veljkoidjuski/povezivanjeRobotskeiLjudskeSake/README.md

Ћао свима! Ми смо група будућих електротехничара рачунара из Средње техничке школе Сомбор :) Ово је веб-презентација нашег најновијег рада.

slikaRukovanje

<span class="oznaceniTekst">,,С левом до победе''</span> слоган је с краја новембра 2025, скован у сврху шале на рачун чињенице да је моделована роботска шака, која је требала бити десна, испала --- лева. Тај низ речи, међутим, постао је временом симбол нашег рада и посвећености остваривању амбициозне замисли: да се од свакодневних, приступачних материјала и школске електронске опреме, без икаквих софистицираних сензора и сличних склопова, направи <span class="oznaceniTekst">приступачан, libre систем с роботском шаком </span> који би могао прецизно пратити покрете људске шаке те тако помоћи човеку у изазовима свакодневнице, било да се ради о опасним индустријским задацима или печењу колача.

Дефинисани циљ пројекта јесмо испунили, али крај се не назире. Стремимо расту пројекта и свим срцем хрлимо у нове инжењерске подвиге! Подржите нас на нашем путу до победе: прва станица --- <span class="oznaceniTekst"> Галаксија куп! </span>

<p align=center>
<video controls style="width:80%">
  <source src="{{ '/video.mp4' | relative_url }}" type="video/mp4">
</video>
</p>

<hr/>

## Новости
