veljkoidjuski/povezivanjeRobotskeiLjudskeSake/elaborat/input.tex

\documentclass[a4paper, 12pt]{article}
\usepackage{amsmath}
\usepackage{fontspec}
\usepackage{setspace}
\usepackage{mathspec}
%\usepackage{unicode-math}
\usepackage{bm}
\setmathfont{Latin Modern Math}
%\setmathfont{XITS Math}
%\setmainfont{Nimbus Roman}
%\setmainfont{Times New Roman}
\setmainfont{XITS}

\makeatletter
\renewcommand\footnotesize{%
  \@setfontsize\footnotesize{10pt}{12pt}}
\makeatother

\usepackage{caption}
\captionsetup{font=footnotesize}
\usepackage{lipsum}
\usepackage{geometry}
\usepackage{afterpage}
\usepackage{graphicx}
\usepackage[serbianc]{babel}
\geometry{top=2cm, bottom=2.5cm, left=2.5cm, right=2.5cm}

\usepackage{setspace}
\usepackage{microtype}

\linespread{1.5}

\begin{document}
\newgeometry{top=5cm, bottom=2.5cm, left=2.5cm, right=2.5cm}

\begin{center}
\textls[250]{\textbf{\fontsize{14pt}{21pt}\selectfont{ПОВЕЗИВАЊЕ РОБОТСКЕ И ЉУДСКЕ ШАКЕ}}}

\textls[250]{\textbf{\fontsize{14pt}{21pt}\selectfont{CONNECTING ROBOTIC AND HUMAN HANDS}}}

\vskip.5\baselineskip

\phantom{.}\hfil \textbf{ВЕЉКО ИЂУШКИ} \hfil \textbf{МИЛОШ МЕЋАВА} \hfil \textbf{АЛЕКСЕЈ ГУДЕЉ} \hfil \phantom{.}

3. и 4. разред Средње техничке школе Сомбор

\vskip.75\baselineskip

\textls[250]{МЕНТОРИ}

\vskip.5\baselineskip

\textbf{МАРИЈАНА БОГДАНОВИЋ}

дипл. инж. електротехнике, СТШ Сомбор

\vskip.5\baselineskip

\textbf{ГОРАН ОПСЕНИЦА}

инж. електронике и телекомуникација, Bosch Србија

\end{center}

\vskip.75\baselineskip

\centerline{\textls[250]{\textbf{1. РЕЗИМЕ}}}
\vskip.5\baselineskip
\input{rezime.txt}

\newgeometry{top=2cm, bottom=2.5cm, left=2.5cm, right=2.5cm}
\centerline{\textls[250]{\textbf{2. ПРИНЦИП РАДА И ПРАКТИЧНА РЕАЛИЗАЦИЈА}}}
\vskip.5\baselineskip
\input{princip.txt}

\vskip.75\baselineskip
\centerline{\textls[250]{\textbf{3. РЕЗУЛТАТ}}}
\vskip.5\baselineskip
\input{rezultati.txt}

\vskip.75\baselineskip
\centerline{\textls[250]{\textbf{4. ЗАКЉУЧАК}}}
\vskip.5\baselineskip
\input{zakljucak.txt}

\vskip.75\baselineskip
\centerline{\textls[250]{\textbf{5. ЗАХВАЛНИЦА}}}
\vskip.5\baselineskip
\input{zahvalnica.txt}

\vskip.75\baselineskip
\fontsize{10pt}{0pt}\selectfont

\centerline{\textls[250]{\textbf{6. ЛИТЕРАТУРА И РЕФЕРЕНЦЕ}}}
\vskip10pt

\input{literatura.txt}

\end{document}
