veljkoidjuski/povezivanjeRobotskeiLjudskeSake/elaborat/assets/input.tex

\documentclass[a4paper, 12pt]{article}
\usepackage{amsmath}
\usepackage{fontspec}
\usepackage{setspace}
\usepackage{mathspec}
%\usepackage{unicode-math}
\usepackage{bm}
\setmathfont{Latin Modern Math}
%\setmathfont{XITS Math}
%\setmainfont{Nimbus Roman}
%\setmainfont{Times New Roman}
\setmainfont{XITS}

\makeatletter
\renewcommand\footnotesize{%
  \@setfontsize\footnotesize{10pt}{12pt}}
\makeatother

\usepackage{caption}
\captionsetup{font=footnotesize}
\usepackage{lipsum}
\usepackage{geometry}
\usepackage{afterpage}
\usepackage{graphicx}
\usepackage[serbianc]{babel}
\geometry{top=2cm, bottom=2.5cm, left=2.5cm, right=2.5cm}

\usepackage{setspace}
\usepackage{microtype}

\linespread{1.5}

\begin{document}
\newgeometry{top=5cm, bottom=2.5cm, left=2.5cm, right=2.5cm}

\begin{center}
\textls[250]{\textbf{\fontsize{14pt}{21pt}\selectfont{ПОВЕЗИВАЊЕ РОБОТСКЕ И ЉУДСКЕ ШАКЕ}}}
\vskip-0.25\baselineskip
\textls[250]{\textbf{\fontsize{14pt}{21pt}\selectfont{CONNECTING ROBOTIC AND HUMAN HANDS}}}

\vskip.1\baselineskip

\phantom{.}\hfil \textbf{ВЕЉКО ИЂУШКИ} \hfil \textbf{МИЛОШ МЕЋАВА} \hfil \textbf{АЛЕКСЕЈ ГУДЕЉ} \hfil \phantom{.}
\vskip-0.25\baselineskip
3. и 4. разред Средње техничке школе Сомбор

\vskip.25\baselineskip

\textls[250]{МЕНТОРИ}

\vskip.125\baselineskip

\textbf{МАРИЈАНА БОГДАНОВИЋ}
\vskip-0.375\baselineskip
дипл. инж. електротехнике, СТШ Сомбор

\textbf{ГОРАН ОПСЕНИЦА}
\vskip-0.375\baselineskip
инж. електронике и телекомуникација, Bosch Србија
\vskip.25\baselineskip
фебруар 2026.
\end{center}
\vskip0.1\baselineskip
\centerline{\textls[250]{\textbf{1. РЕЗИМЕ}}}
\vskip.25\baselineskip
\input{rezime.txt}

\newgeometry{top=2cm, bottom=2.5cm, left=2.5cm, right=2.5cm}
\begin{figure}
\centering
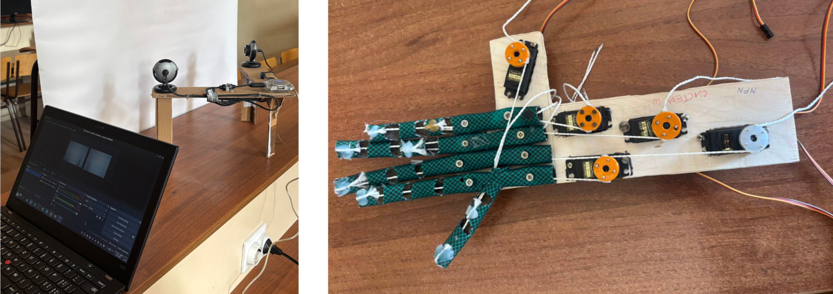
[picture p1: elaborat/assets/1.png]

\caption{\centering \it лево: систем $\alpha$; десно: систем $\omega$}
\vskip-0.8\baselineskip
\caption*{Figure 1: \it left: system $\alpha$; right: system $\omega$}
\end{figure}
\centerline{\textls[250]{\textbf{2. ПРИНЦИП РАДА И ПРАКТИЧНА РЕАЛИЗАЦИЈА}}}
\vskip.5\baselineskip
\input{princip.txt}

\vskip.5\baselineskip
\centerline{\textls[250]{\textbf{3. РЕЗУЛТАТ}}}
\vskip.25\baselineskip
\input{rezultati.txt}

\vskip.5\baselineskip
\centerline{\textls[250]{\textbf{4. ЗАКЉУЧАК}}}
\vskip.25\baselineskip
\input{zakljucak.txt}

\vskip.5\baselineskip
\centerline{\textls[250]{\textbf{5. ЗАХВАЛНИЦА}}}
\vskip.25\baselineskip
\input{zahvalnica.txt}

\vskip.5\baselineskip
\fontsize{10pt}{9pt}\selectfont

\centerline{\textls[250]{\textbf{6. ЛИТЕРАТУРА И РЕФЕРЕНЦЕ}}}
\vskip10pt

\input{literatura.txt}

\end{document}
