veljkoidjuski/povezivanjeRobotskeiLjudskeSake/prezentacijaSpanci/prez.pdf

## CONNECTING ROBOTIC AND HUMAN HANDS

V. Iđuški | A. Gudelj | M. Mećava | D. Farkaš

Secondary Technical School of Sombor

March 2026.

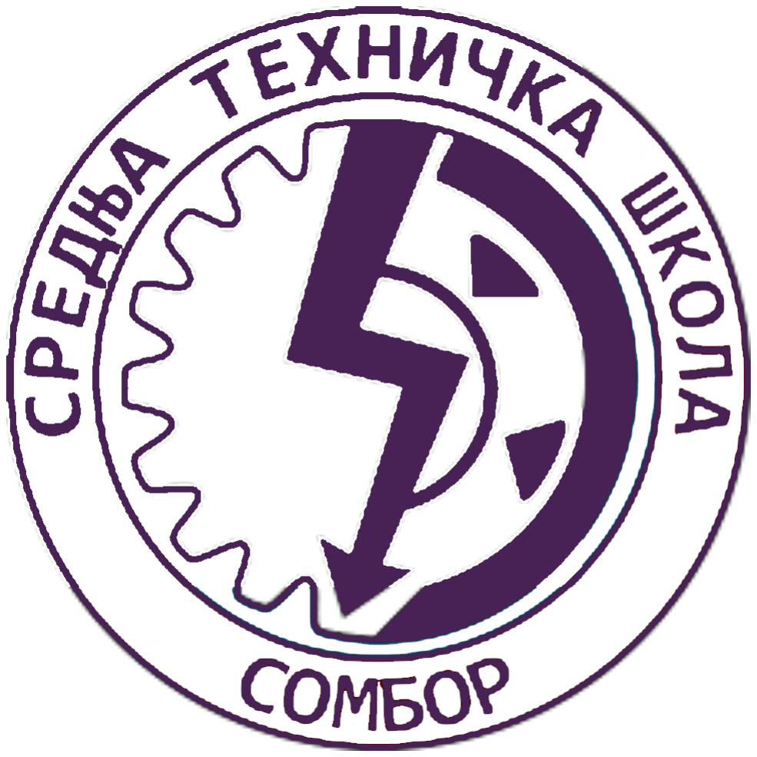
[picture p13: figure]

## MOTIVATION

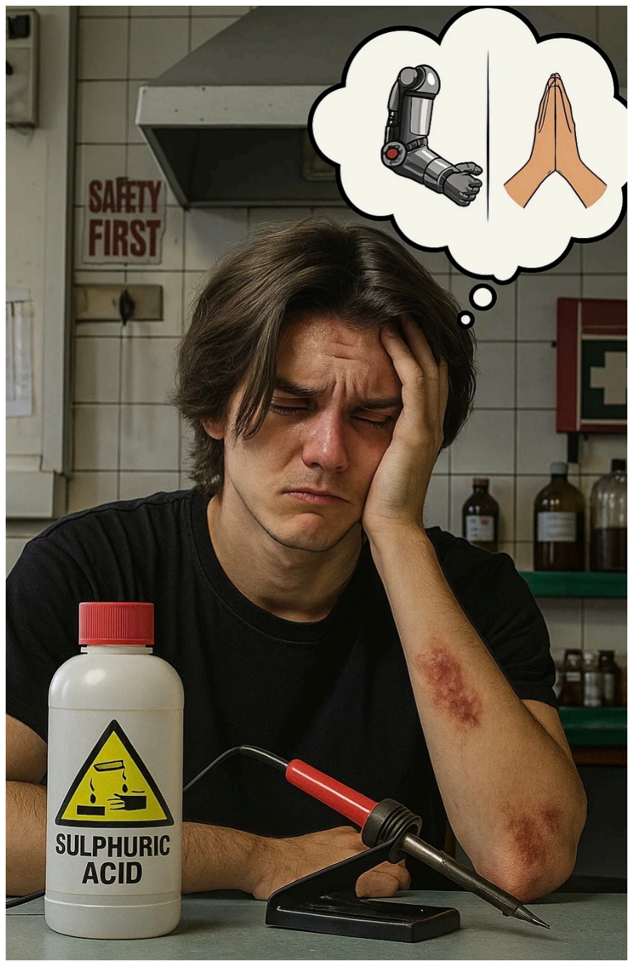
[picture p14: figure]

Figure: How generative
AI imagines our
problem
- Industry is dangerous!
- Alas! — if only there were something that would enable us to carry out perilous tasks just as we would with our bare hands, yet without touching the dangerous stuff...
Iđuški, Mećava, Gudelj, Farkaš — CONNECTING ROBOTIC AND HUMAN HANDS | 2 / 7

## OUR IDEA

- To build an interface between the human hand and a custom robotic hand through webcams
Iđuški, Mećava, Gudelj, Farkaš — CONNECTING ROBOTIC AND HUMAN HANDS | 3 / 7

## SEGMENTATION OF THE PROJECT

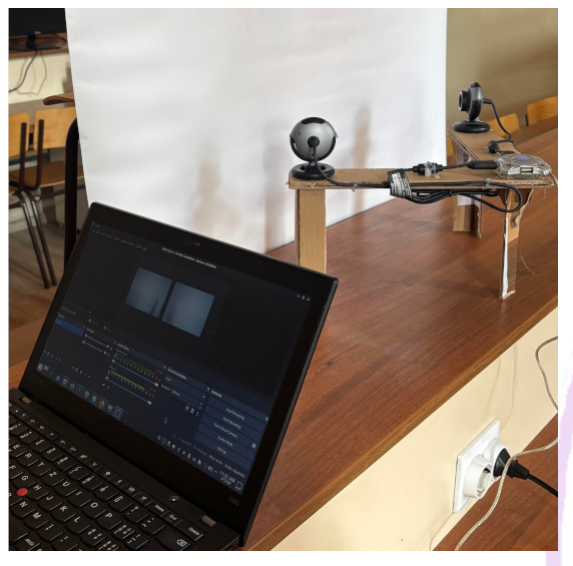
[picture p15: figure]
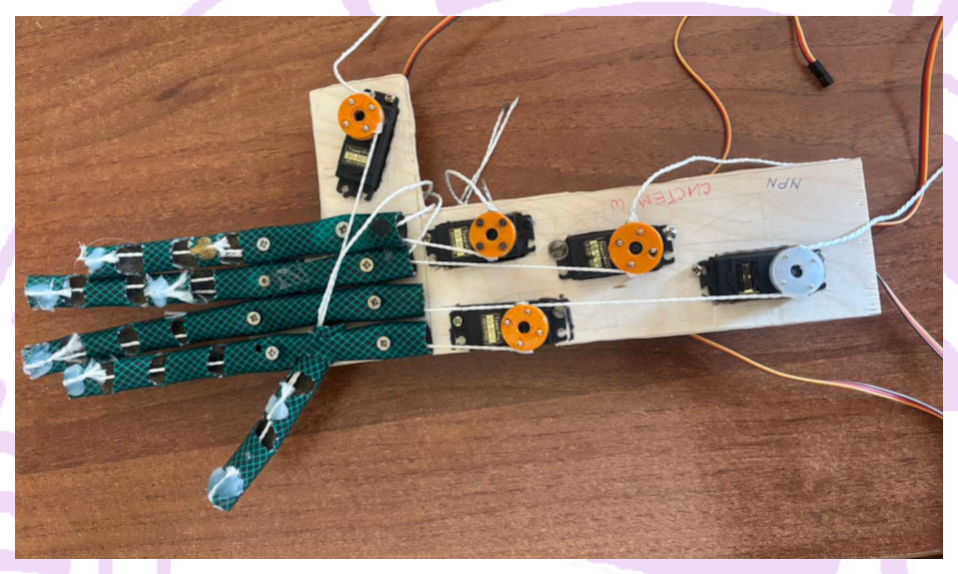
[picture p16: figure]

- System α | ▶ System ω
Iđuški, Mećava, Gudelj, Farkaš — CONNECTING ROBOTIC AND HUMAN HANDS | 4 / 7

## SYSTEM α

- The image processing segment
- Comprises a Thinkpad and two webcams on a special stand
- The webcams have matching y axes and orthogonal x axes, enabling production of images suitable for finger triangulation
- Tasks it takes care of:

### 1. camera calibration 2. image segmentation (finger detection) 3. finger triangulation 4. control number inference 5. message encoding and transmission

- A special mathematical model of finger movement was conceived so as to satisfy the needs of System α — the ’Kinderica’ Model
Iđuški, Mećava, Gudelj, Farkaš — CONNECTING ROBOTIC AND HUMAN HANDS | 5 / 7

## SYSTEM ω

- The actuator segment
- Consists of the robotic hand model, servo motors and an Arduino Uno
- The hand is fashioned from plywood, garden hose pieces and thin synthetic rope
- The design leverages the elasticity of rubber
- Finger movement regulation is achieved through servo motors
Iđuški, Mećava, Gudelj, Farkaš — CONNECTING ROBOTIC AND HUMAN HANDS | 6 / 7

## RESULTS

- A functional hand model
- Successful implementation of numerical control
- Successful setup of the interface between the subsystems
- Successful finger triangulation (by colour)

TO DO (tasks of critical priority):
- Control number inference
- Implementation of the ’Kinderica’ Model
- Implementation of ML techniques so as to phase out segmentation by colour
Iđuški, Mećava, Gudelj, Farkaš — CONNECTING ROBOTIC AND HUMAN HANDS | 7 / 7
