veljkoidjuski/povezivanjeRobotskeiLjudskeSake/hardver/hardver.pdf

HARDVER PROJEKTA

Sekcija robotike STS Sombor ˇ

Abstract. Hardver projekta podeljen je na dva glavna dela: sistem α i sistem ω. U ovom radu opisan je hardver obaju delova projekta.

SISTEM α

Sistem α bavi se prihvatom i obradom podataka. Cine ga IBM-PC-kompatibilan ˇ računar (trenutno Thinkpad X280) i dve kamere (Microsoft LifeCam VX-3000) postavljene na u horizontalnoj ravni, tako da su im sopstvene x ose ortogonalne, a y ose paralelne. Za potrebe fiksiranja položaja kamera izrad–en je naročit stalak od kartona. (Slika 1)

SISTEM ω

Sistem ω jeste izvršni element projekta. Njegova električna šema može se videti na slici 2. Cine ga robotska šaka, servo motori i platforma Arduino Uno. ˇ

Saka ˇ

Glavna hardverska komponenta projekta jeste robotska šaka (slika 3), koji je sačinjen od šperploče koja je osnova šake i komada baštenskog creva koji odgovaraju ljudskim prstima.
Svaki prst usečen je na takvim mestima da useci vrše ulogu zglobova. Useci su tako napravljeni da verno oponašaju kretanje realne ljudske šake.
Za upravljanje prstima napravili smo tetive, za šta smo upotrebili tanke sintetičke kanape. Jedan kraj svakog kanapa pričvršćen je za unutrašnju stranu prsta, a drugi namotan na kotur na osovini odgovarajućeg motora. Ukupno ima dva kanapa po prstu, što čini da svaki prst ima dva stepena slobode. Trenutno se koristi samo jedna sajla po prstu (ona pričvršćena pri vrhu), tako da je u upotrebi 5 servo motora, a prsti imaju po jedan stepen slobode (slika 4). Druga sajla utiče samo na zglob najbliži dlanu i njeno potpuno izvlačenje, bez povlačenja prve tetive, čini da se ceo prst postavi (gotovo) normalno na ravan dlana (slika 5).

Servo motori i njihova uloga

Veoma važni elektromehanički aktuatori u našem projektu su pozicioni servo motori koji omogučavaju regulisano kretanje prstiju.
Servo motori su elektromehanički ured–aji. Postoje oni koji precizno regulišu položaj, tj. ugao otklona, oni koji precizno regulišu brzinu obrtanja i oni koji precizno regulišu obrtni moment.

Typeset by AMS-TEX
1

2 | SEKCIJA ROBOTIKE STS SOMBOR ˇ

Koristimo servo motore SG-5010 (slika 6), ugrad–ene u podlakticu šake. Na njihove rotore pričvršćeni su 3D štampani koturovi na koje su namotane tetive.
Za upravljanje servo motorima koristi se mikrokontrolerska platforma Arduino Uno (slika 7), koji generiše odgovarajuće PWM signale za svaki motor. Motori se, zbog velike ukupne snage, napajaju laboratorijskim napajanjem.

HARDVER PROJEKTA | 3

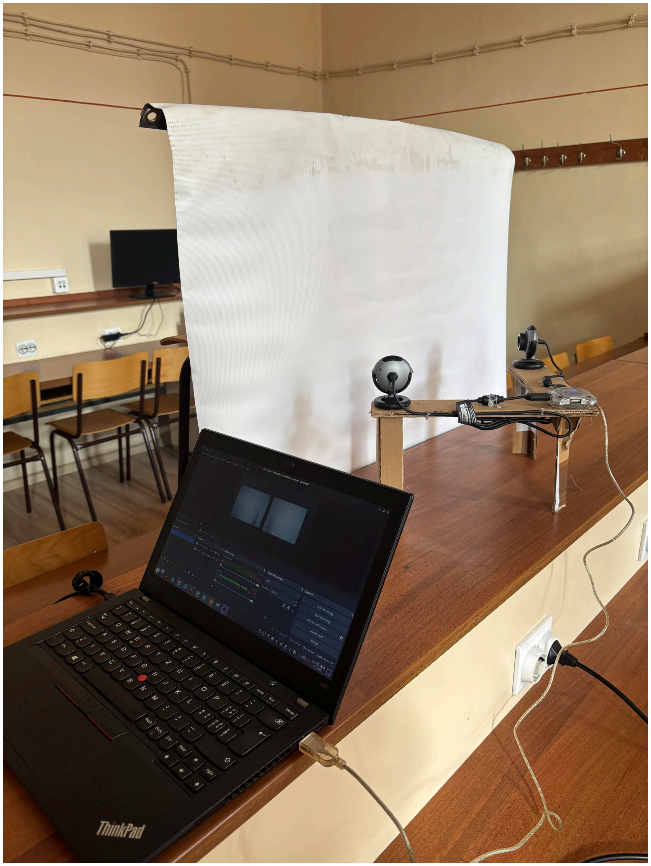
[picture p17: figure]

Slika 1. Sistem α


Slika 2. električna šema sistema ω

4 | SEKCIJA ROBOTIKE STS SOMBOR ˇ

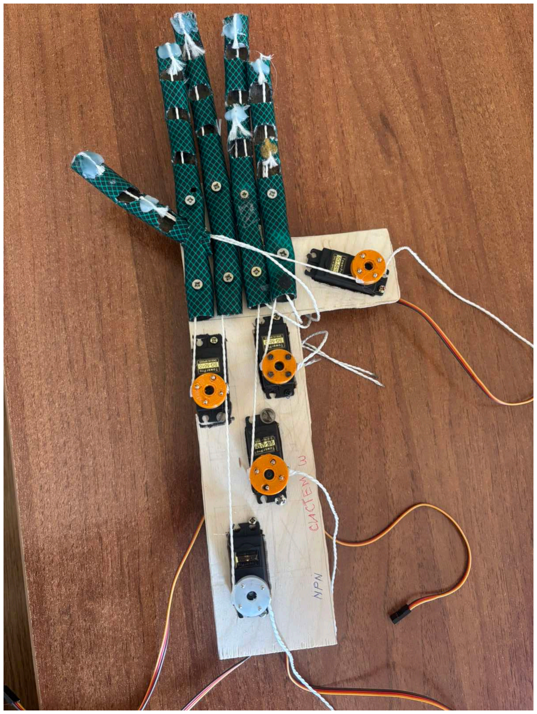
[picture p18: figure]

Slika 3. robotska šaka


Slika 4. položaj prsta pri maksimalnom izvlačenju tetive koja je u upotrebi

HARDVER PROJEKTA | 5

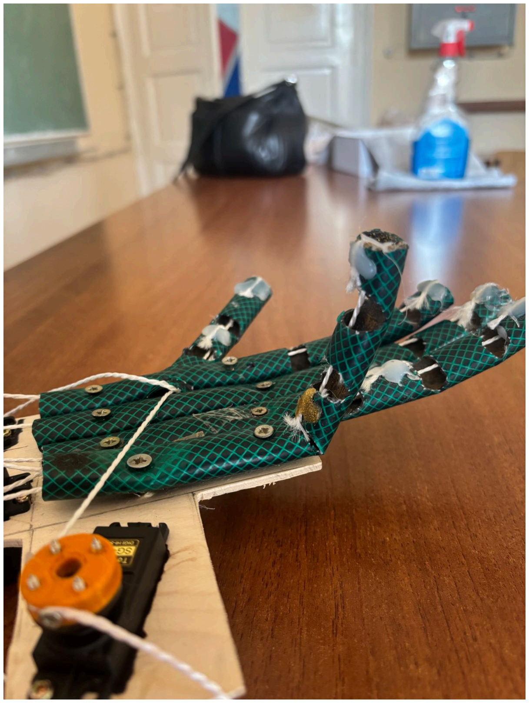
[picture p19: figure]

Slika 5. položaj prsta pri maksimalnom izvlačenju druge tetive

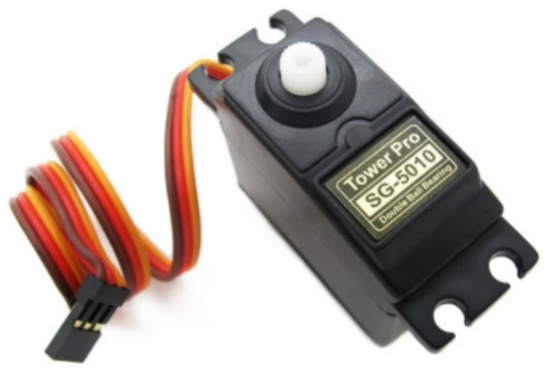
[picture p20: figure]

Slika 6. korišćeni servo motor | Slika 7. platforma Arduino Uno
