veljkoidjuski/povezivanjeRobotskeiLjudskeSake/elaborat/elaborat.pdf

П О В Е З И В А Њ Е Р О Б О Т С К Е И Љ У Д С К Е Ш А К Е C O N N E C T I N G R O B O T I C A N D H U M A N H A N D S

ВЕЉКО ИЂУШКИ | МИЛОШ МЕЋАВА | АЛЕКСЕЈ ГУДЕЉ
3. и 4. разред Средње техничке школе Сомбор
| М Е Н Т О Р И

МАРИЈАНА БОГДАНОВИЋ
дипл. инж. електротехнике, СТШ Сомбор
| ГОРАН ОПСЕНИЦА
инж. електронике и телекомуникација, Bosch Србија
| фебруар 2026.
| 1 . Р Е З И М Е

У овом раду приказан је досадашњи напредак секције роботике Средње техничке шко-

ле Сомбор на путу до осмишљања бесконтактног интерфејса људске и роботске шаке

посредством веб-камера и опонашања покрета људске шаке роботском. Предмет истра-

живања јесте могућност остваривања таквог интерфејса, а циљ јесте успоставити такав

интерфејс. У оквиру рада конструисан је модел леве шаке, од свакодневних материјала,

чију покретљивост обезбеђују серво мотори. Конструисан је и нарочит систем камера

који прикупља слике прикладне за предвиђену обраду. Ради управљања шаком, осми-

шљена је математичка апроксимација кретања врха прста шаке. Обезбеђен је серијски

интерфејс рачунара и микроконтролерске платформе Arduino Uno. Утврђен је шаблон

по ком рачунар прослеђује бројеве микроконтролеру и постигнута нумеричка контрола

шаке. Методом сингуларне декомпозиције матрице успешно је рачунарски реализована

тријангулација тачке на основу симултаних слика двају камера. Уз одговарајућу сегмен-

тацију слике (која је имплементирана на два начина) и математичке моделе прстију, то

је омогућило генерисање управљачких сигнала на основу двеју временски коинцидентал-

них слика шаке. Циљ пројекта тиме је испуњен. Даљи план рада подразумева развијање

сопственог ВИ модела за препознавање обележја шаке те померање граница и повећање

димензионалности фазних простора прстију роботске шаке.

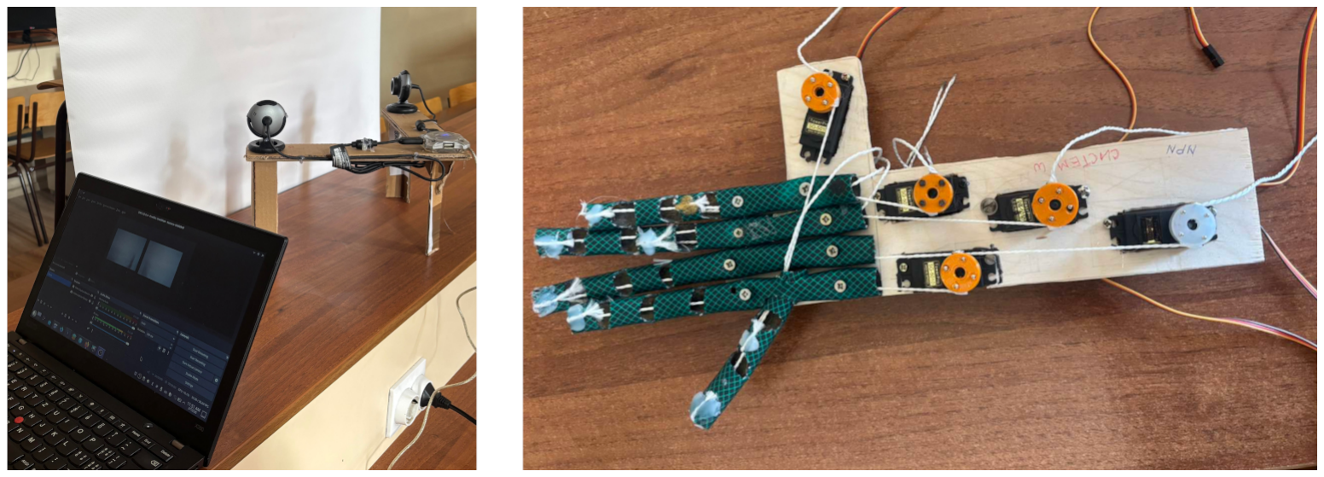
[picture p22: figure]

Слика 1: лево: систем α; десно: систем ω Figure 1: left: system α; right: system ω

2 . П Р И Н Ц И П Р А Д А И П Р А К Т И Ч Н А Р Е А Л И З А Ц И Ј А

2 . 1 . М а т е м а т и ч к и о с н о в и

Модел „Kиндерица”. Нек је x ортогонална пројекција врха прста на осу паралелну

прсту када је опружен, ∆l — промена дужине дела тетиве унутар прста, ϕ0 — угао усека на прсту када је опружен, а σ0 = tgϕ0
2

. Врх прста роботске шаке креће се по закону (1)[1] .

x = 2l

(
2τ

3 + τ

2 − τ

)
(1)
τ = cos (

ϕ0 − 2 arctg (
σ0 −

∆l
6

))

Тријангулација тачке. Нека је R тачка у простору коју две камере у сопственим ко-

ординатним системима виде као r1 и r2. Нек су „матрице камера” P1 и P2. Знајући r1, r2, P1 и P2, R се може наћи решавањем система једначина (2)[2]
r1 × P1R = 0 | ∧ r2 × P2R = 0 | (2)

Сингуларна декомпозиција матрице. Свака матрица може се записати у облику про-

извода матрица UΣV

†
, где су U и V

† ротације, а Σ — скалирање[3] .

2 . 2 . Х а р д в е р п р о ј е к т а [4]

Пројекат је сегментован у две целине: систем α и систем ω (слика 1). Систем α бави

се прихватом и обрадом података, а систем ω извршним делом пројекта.

Систем α чине IBM-PC-компатибилан рачунар и две веб-камере постављене у хори-

зонталној равни, тако да су им сопствене x осе ортогоналне, а сопствене y осе паралелне.

За потребе фиксирања положаја камера израђен је нарочит сталак од картона.

Систем ω чине роботска шака, серво мотори и платформа Arduino Uno.

Роботска шака јесте главна компонента система ω. Израђенa је од обликованог комада

шперплоче који чини основу шаке и комада баштенског црева који одговарају људским

прстима. Управљање прстима врши се по једним танким синтетичким канапом — тетивом.

Кретање прстију накнадно је регулисано оловним тегићима и еластичним тракама за косу.

Серво мотори омогућавају управљање повлачењем тетива. Користе се серво мотори

SG-5010 уграђени у подлактицу модела. За управљање моторима користи се микрокон-

тролерска платформа Arduino Uno, која генерише одговарајуће PWM сигнале. Мотори

се, због велике укупне снаге, напајају лабораторијским напајањем.

2 . 3 . С о ф т в е р п р о ј е к т а [5]

Софтвер система α обавља калибрацију камера, аквизицију слика, обраду сликa, три-

ангулацију тачака, генерацију управљачких бројева и кодовање и слање истих. Програм-

ски ко̂д система α писан је у програмском језику Python, помоћу библиотека numpy, opencv,

bisect, verb!threading! и pyserial.

Калибрација камере јесте операција којом се добија матрица K, која пројектује тачке

простора у сопственом координатном систему камере на раван слике. Матрица P , потреб-

на за тријангулацију тачака, јесте матрица K изражена у спољним координатама. За по-

требе калибрације користе се тест-слике шаховнице утврђених димензија. Калибрација

камере врши се функцијом calibrateCamera библиотеке opencv.

[6]

Аквизиција слике обавља се у двема посебним нитима (по једна за сваку камеру), по-

моћу метода grab и retrieve класе VideoCapture библиотеке opencv, како се не би

гушио бафер камера те како би главној нити на располагању увек била актуелна слика,

тј. како анализа слике не би акумулирала кашњење.

Координате за нас значајних тачака шаке издвајају се на два начина: применом услуга библиотеке mediapipe[10] или сегментацијом слике по боји (при чему тестер на шаку ста-

вља нарочиту рукавицу с означеним прстима и стаје испред белог застора). Метод detect

класе detector библиотеке mediapipe враћа директно координате значајних тачака, док

се у случају сегментације по боји оне мере центром масе означених пиксела.

Триангулација тачке, тј. решавање система једначина (2), обавља се применом сингу-

ларне декомпозиције матрице, коју омогућава функција svd библиотеке numpy. Проблем тријангулације своди се на минимизацију |ARˆ| по Rˆ, где је A матрица у зависности од

r1, r2, P1 и P2. To се савладава узимањем за решење оне колоне матрице V која се (након

транспоновања) множи најмањим бројем из (дијагоналне) матрице Σ, а то је по дефиницији крајња десна[7]

Управљачки бројеви одређују се мапирањем односа дужине пројекције вектора по-

ложаја врха прста у координатном систему шаке на правац опруженог прста и дужине опруженог прста на угао отклона мотора. То се остварује применом математичких мо-

дела прстију, сведених на први хармоник због преосетљивости модела „Киндерица” на

неидеалности прстију.

Добијени бројеви кодују се у шаблонску 128-битну поруку. Актуелну поруку посебна

нит шаље USB комуникацијом систему ω помоћу метода write класе Serial библиотеке pyserial, којему се као једини параметар прослеђује бинарна порука[8]

Софтвер система ω писан је у програмском језику C++, помоћу хедера Arduino.h, и

крајње је једноставан. Када Аrduino прими поруку од система α (детектује битове у бафе-

ру методом available класе Serial), чува је у ниску предвиђену за ту намену помоћу

метода readString класе Serial, цепа је на трословне сегменте и одбацује знак за нови

ред. Трословне сегменте потом тумачи као декадне бројеве помоћу метода toInt класе String те на основу њих генерише PWM сигнале за серво моторе прстију[9]

3 . Р Е З У Л Т А Т

Направљен је функционалан модел леве шаке користећи шперплочу, баштенско цре-

во, синтетички канап, серво моторе, оловне тегиће и траке за косу.

Модел шаке повезан је на платформу Arduino Uno и постигнуто je нумеричко упра-

вљање моторима.

Успешно је спрегнут Arduino са рачунаром USB комуникацијом. Arduino исправно

тумачи шаблонске поруке послате са рачунара.

Склопљен је систем камера које дају слике спремне за обраду. Извршена је калибра-

ција камера, чиме су одређене матрице камера потребне за тријангулацију тачке.

Постигнуто је управљање роботском шаком положајем људске шаке у реалном вре-

мену помоћу библиотеке mediapipe (слика 2). Могуће је управљање и применом сегмен-

тације по боји, али је ограничено ротацијом шаке и није га могуће вршити у реалном

времену. Прагови детекције прстију нису у довољној мери стабилни.

4 . З А К Љ У Ч А К

Испуњен је циљ рада. Роботска шака прати кретање људске шаке на основу слика с

двеју камера.

План даљег рада у циљу побољшања решења подразумева побољшање модела за де-

текцију прстију сегментацијом боје, развијање ВИ модела за издвајање прстију детекци-

јом обележја те проширивање фазних простора прстију. У плану даљег рада јесте и мере-

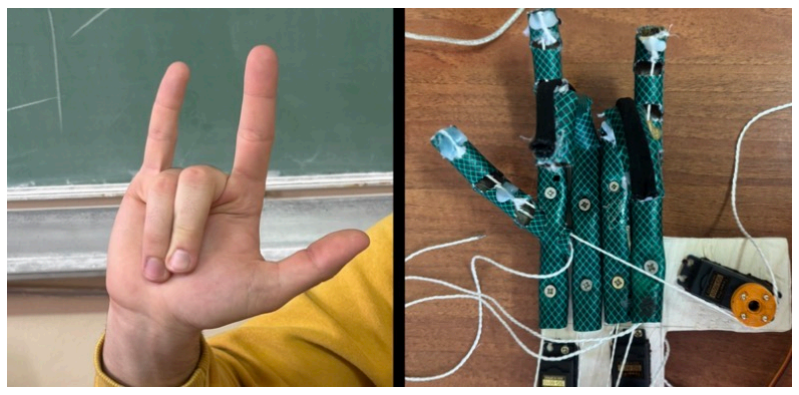
[picture p23: figure]

Слика 2: лево: задата поза шаке; десно: положај који заузима роботска шака Figure 2: left: human hand pose; right: pose reconstructed by the robotic hand

ње перформанси ради евалуације пројекта.

5 . З А Х В А Л Н И Ц А

Захваљујемо Денису Фаркашу, који је такође учествовао у изради пројекта, на залага-

њу и помоћи. Захваљујемо нашим менторима, Маријани Богдановић и Горану Опсеници,

на стручном навођењу ка циљу пројекта и издвојеном времену. Захваљујемо Средњој тех-

ничкој школи на простору и материјалу за рад и свим нашим професорима који су имали

разумевања за наше изостајање с наставе. Захваљујемо Милораду Недељкову на уступа-

њу веб-камера и Дејану Богдановићу на донацији серво мотора. Захваљујемо Радовану

Јелачи на услузи 3D штампе. Захваљујемо Лазару Добрићу на прослеђивању литературе

за обраду слике применом техника машинског учења.

6 . Л И Т Е Р А Т У Р А И Р Е Ф Е Р Е Н Ц Е

[1]V. Iđuški, M. Mećava, A. Gudelj, Model „Kinderica”, Povezivanje robotske i ljudske šake, Сомбор, 2026. URL: https://github.com/veljkoidjuski/povezivanjeRobotskeiLjudskeSake/blob/master/kinderica/kinderica.pdf [2]R. Boomgaard, L. Dorst, Triangulation, Computer Vision, Universiteit van Amsterdam, Амстердам, 2021. URL: https://staff.fnwi.uva.nl/r.vandenboomgaard/ComputerVision/LectureNotes/CV/StereoVision/triangulation.html [3]M. Embree, Matrix Methods for Computational Modeling and Data Analysis, Virginia Tech, Блексбург, 2019. URL: h t t p s : / / p e r s o n a l . m a t h . v t . e d u / e m b r e e / c m d a 3 6 0 6 / c h a p t e r 6 . p d f [4]V. Iđuški, M. Mećava, A. Gudelj, Hardver projekta, Povezivanje robotske i ljudske šake, Сомбор, 2026. URL: https://github.com/veljkoidjuski/povezivanjeRobotskeiLjudskeSake/blob/master/hardver/hardver.pdf [5]V. Iđuški, M. Mećava, A. Gudelj, Softver projekta, Povezivanje robotske i ljudske šake, Сомбор, 2026. URL: https://github.com/veljkoidjuski/povezivanjeRobotskeiLjudskeSake/blob/master/softver/softver.pdf [6]Open Source Computer Vision, Camera Calibration, приступ 22. 2. 2026.
URL: h t t p s : / / d o c s . o p e n c v . o r g / 4 . x / d c / d b b / t u t o r i a l _ p y _ c a l i b r a t i o n . h t m l [7]Kris Kitani, Triangulation, 16-385 Computer Vision, Carnegie Mellon University, Питсбург, 2017.
URL: h t t p s : / / w w w . c s . c m u . e d u /∼1 6 3 8 5 / s 1 7 / S l i d e s / 1 1 . 4 _ T r i a n g u l a t i o n . p d f [8]pySerial API, приступ 22. 2. 2026. URL: https://pyserial.readthedocs.io/en/latest/pyserial_api.html [9]ARDUINODOCS, Serial, приступ 22. 2. 2026.
URL: https://docs.arduino.cc/language-reference/en/functions/communication/serial [10]Google AI Edge, Hand Landmarks Detection Guide, приступ 19. 3. 2026.
URL: https://ai.google.dev/edge/mediapipe/solutions/vision/hand_landmarker
