veljkoidjuski/povezivanjeRobotskeiLjudskeSake/softver/softver.pdf

SOFTVER PROJEKTA

Sekcija robotike STS Sombor ˇ

Povezivanje robotske i ljudske šake

Abstract. U ovom radu opisan je softver sistema α i sistema ω.

SISTEM α

Kalibracija kamera

Kalibracija kamere jeste postupak kojim se utvrd–uje matrica kamere P, takva da je
αPX = x, | (1)

gde je X proizvoljna tačka prostora unutar vidnog polja kamere, x položaj iste tačke na slici, a α ∈ R. Kalibracija kamere omogućava trijangulaciju tačke. Kalibracija kamere radi se jedanput, nakon što se kamera fiksira — nakon toga, matrica se više ne menja (zavisi od položaja kamera te fizičkih osobina sočiva i senzora) i nema potrebe ponavljati kalibraciju.
Kalibracija kamere obavlja se pomoću funkcije calibrateCamera biblioteke cv2 (OpenCV), na osnovu test-slika (iste) šahovnice. Funkcija prima:
(1) niz nizova vektora ((S)), koji daje koordinate tačaka mreže šahovnice u njenom sopstvenom koordinatnom sistemu, izražene u jedinicama stranice polja šaho-vnice. Dat je jednakošću (2), gde je w širina, a h visina šahovnice izražena u istim jedinicama. Svi nizovi (S) med–usobno su jednaki — njihovo umnožavanje stvar je implementacije funkcije.
(S) = (an)

d=1
0<n≤w × (bn)

d=1
0<n≤h

(2)

(2) niz nizova vektora ((x)), koji daje za svaku sliku koordinate tačaka mreže šahovnice u pikselima u koordinatnom sistemu kamere. Niz (x) za datu (sivu) sliku utvrd–uje se evaluacijom funkcije findChessboardCorners biblioteke cv2 nad tom slikom, poznajući dimenzije šahovnice u jedinicama stranice polja.
(3) vektor d, koji daje dimenzije slike u pikselima. U našem slučaju, to je vektor h
280

320 i
, jer koristimo slike širine 320px i visine 280px.

Typeset by AMS-TEX
1

2 | SEKCIJA ROBOTIKE STS SOMBOR ˇ

Izlaz f-je calibrateCamera jeste 5-torka, čiji je najvažniji element matrica K, takva da je:
P = K[R|t] | (3)

Matrica R jeste matrica rotacije kamere, a vektor t — vektor translacije kamere. Ispod je priložen kod. U njemu nije obavljena obrada matrice K — to se radi u rutini za trijangulaciju. Napomena: konvencija imenovanja je izmenjena!

import cv2
from matplotlib import pyplot as plt import numpy as np
import glob

criteria = (cv2.TERM_CRITERIA_EPS + cv2.TERM_CRITERIA_MAX_ITER, 30, 0.001)

objp = np.zeros((7*9,3), np.float32)
objp[:,:2] = np.mgrid[0:9,0:7].T.reshape(-1,2)

objpoints = []
imgpoints = []

images = glob.glob(’/home/veljaaas/Documents/sekcija/kamereDruga/*.png’) images.sort()
print(images)

for fname in images:
print(fname)
img = cv2.imread(fname)
gray = cv2.cvtColor(img, cv2.COLOR_RGB2GRAY)

ret, corners = cv2.findChessboardCorners(gray, (9,7), None)

if ret == True:
objpoints.append(objp)

corners2 = cv2.cornerSubPix(gray,corners, (11,11), (-1,-1), criteria) imgpoints.append(corners2)

cv2.drawChessboardCorners(img, (9,7), corners2, ret)
plt.imshow(img)
plt.show()

ret, mtx, dist, rvecs, tvecs = cv2.calibrateCamera(

objpoints,
imgpoints,
gray.shape[::-1],

None,
None
)

SOFTVER PROJEKTA | 3

Prikupljanje slika

Slike s kamera stalno preuzimaju dve zasebne niti, kako se ne bi zapunio bafer te kako bi glavna nit mogla dobijati slike u realnom vremenu (tj. kako glavna nit ne bi unosila kašnjenje u čitanje slika). Beleže se samo najnoviji kadrovi s obeju kamera. Slike se preuzimaju metodima grab i release klase V ideoCapture biblioteke cv2. Metodom grab prihvata se kadar iz bafera u privremeno skladište, pa se metodom release isti predaje programu. Primer koda za jednu kameru priložen je ispod.

def citajKamera1():
global kamera1Najnoviji
global camera1
while True:
if camera1.grab():
ret, kamera1Najnoviji = camera1.retrieve()
nit1 = threading.Thread(target = citajKamera1, args=()) nit1.start()

Obrada slike

Cilj obrade slike jeste merenje koordinata svih vrhova prstiju i drugih značajnih tačaka šake na slikama s obeju kamera. Implementirana su dva metoda obrade slike: primenom biblioteke mediapipe (pristup koji smo pozajmili) i primenom segmentacije po boji (pristup koji smo osmislili).
(1) Biblioteka mediapipe nudi istrenirani VI model za detekciju 21 značajne tačke dlana. Priloženim isečkom koda može se formirati niz vektora kojim su date koordinate značajnih tačaka dlana na slici, ukoliko se dlan vidi dobro na slici.

try:
detection_result = detector.detect(image) koordinateA = np.array([(a.x*320, a.y*240)
for a in detection_result.hand_landmarks[0]]) except:
continue
(2) Osnovna ideja postupka sa segmentacijom po boji jeste da, ukoliko ofarbamo svaki prst u drugu boju (kao i ,,koren” dlana — referentnu tačku), sve ostalo u kadru učinimo hromatski neutralnim, uzmemo sliku te odredimo centre masa pojedinačnih boja, možemo doznati koordinate svih prstiju na toj slici.
Uzimaju se dve slike (iz razloga koji će kasnije biti definisan) — jedna otvorene šake, i jedna šake u željenom položaju, tako da se izmed–u njih nije desila rotacija šake (translacija je dopuštena i ne utiče na dalje merenje). Nad obema slikama primenjuje se Gausov NF filtar u cilju smanjivanja detaljnosti slike (relevantni su samo veliki klasteri boja na vrhovima prstiju; detekcija drugih, neočekivanih stvari narušava rad programa). To omogu-ćava f-ja GaussianBlur biblioteke cv2.

4 | SEKCIJA ROBOTIKE STS SOMBOR ˇ

Slike se potom prevode u L ∗ a ∗ b∗ prostor boja, odabran iz tog razloga što je u njemu nijansa svetla (koja će ubrzo biti definisana) poprilično invarijantna po intenzitetu svetlosti (ista površina uvek će imati približno istu nijansu pod svetlom istog frekv. spektra). U odabranom prostoru boja, boja je zadata vektorom [ L a b ]

†
∈ (R
3
)

†
, a

2 + b

2 ∈ [0, c0

2
], L ∈ [0, L0].
Parametar L odnosi se na osvetljaj, a a i b — na hromatski sadržaj. Nijansu možemo definisati kompleksnim brojem:
bc = a + jb | (4)

(projekcija boje na ab ravan). Moduo tog broja c = ∥bc∥ =

√

## bc bc

∗ =

√
a

2 + b

2
govori o zasićenosti boje, a argument ϕ = arg bc = arctg b
a — o tome je li boja
crvena, zelena itd. (ϕ = π ± π — crvena, ϕ = π/2 — žuta...). Baratajući isključivo tim brojem (stavljanjem c i ϕ u granice) mogu se definisati pragovi detekcije prstiju. Na osnovu tih pragova mogu se generisati binarne slike koje označavaju pojedinačne prste. Primer implementacije dat je ispod (za plavu ref. tačku). Napomena: konvencija imenovanja je izmenjena!

slika1cir = np.array(slika1fi.copy(), dtype=np.int32)
maska1ir = 255*((np.arctan2(slika1cir[:,:,2]-128, slika1cir[:,:,1]-128) > -np.pi/2) & (np.arctan2(slika1cir[:,:,2]-128, slika1cir[:,:,1]-128) <= -np.pi/3.5)
& (np.abs(slika1cir[:,:,1]-128
+ 1j* (slika1cir[:,:,2]-128)) > 0.1*256))

Kad su izdvojene binarne slike, koordinate centra mase lako se odred–uju primenom funkcija argwhere i mean biblioteke numpy. Funkcija argwhere uzima n-dimenzionalni niz i vraća niz 2-vektora (x) gde svako x daje koordinate jedne od tačaka u kojima je zapamćena vrednost različita od 0. Funkcija mean vraća srednju vrednost prosled–enog niza. Isečak koda ispod malo je izmenjen radi lakšeg razumevanja imenovanja.

def centarMase(maska1):
kz1 = np.argwhere(maska1)
cxz1 = np.mean(kz1[:,1])
cyz1 = np.mean(kz2[:,0])
return (cxz1, cyz1)

Saznavanjem centara mase binarnih slika završena je obrada slike. Mana ovog pristupa jeste osetljivost na uslove osvetljenosti (iako je osetljivost na intenzitet svetlosti sprečena). Ne mogu se tako lako odabrati dovoljno veliki segmenti spektra boja kao granice za svaki prst jer bi se preklopili!

Triangulacija tacaka ˇ
Triangulacija tačke jeste problem utvrd–ivanja položaja tačke u prostoru na osnovu njenog položaja u dvema slikama, vremenski koincidentalnim a prostorno nekoincidentalnim. Ukoliko poznajemo položaje tačke na slikama s kamera 1 i 2 r1 i r2 te matrice kamera 1 i 2 P1 i P2 problem se svodi na nalaženje takvih realnih parametara α i β i takve tačke R da bude

r1 = αP1R

^
r2 = βP2R. | (5)

SOFTVER PROJEKTA | 5

Taj sistem jednakosti, med–utim, u ovom obliku nije naročito koristan, budući da ima tri nepoznate. Primetimo da važi

PiR × ri = 0. | (6)

Tako su iz posla sklonjeni parametri α i β, i jedina preostala nepoznata jeste R. Uz odred–ene transformacije:

y1p

†
13 − p

†
12
p

†
11 − x1p

†
13
y2p

†
23 − p

†
22
p

†
21 − x2p

†
23
R = 0, | (7)

gde je pij j-ta kolona matrice Pi

. Skraćeno:

AR = 0. | (8)

U praktičnoj primeni, rešavanje jednakosti (8) biće jalovo — rešenje najčešće nećemo dobiti jer se zbog postojanja nenulte greške merenja zraci koji upadaju u kamere a na kojima leže merene tačke u najveém broju slučajeva razmimoilaze. Problem, dakle, treba modifikovati u minimizaciju.

R = arg minQ,∥Q∥=1∥AQ∥ | (9)

(R i Q dati su homogenim koordinatama; ograničenje intenziteta jeste fiktivno i služi da omogući dalji rad). Primenjuje se jedan vrlo elegantan metod rešavanja
(9). Naime, ukoliko je singularna dekompozicija matrice A = UΣV† | , garantuje se
da je traženo R dato krajnjom desnom kolonom matrice V.
Implementacija ovog algoritma u kodu data je ispod. Nema potrebe raditi konverziju u bilo koje konkretne jedinice dužine — ostatak posla zasnovan je na odnosima. Koordinatnim početkom smatra se ugao kartonskog nosača. Napomena: konvencija imenovanja je izmenjena!

def trijangulacijaTacke(r1, r2):
kameraB = np.array([
[1, 0, 0, -1],
[0, 0, -1, 0],
[0, 1, 0, 0]
])
kameraB = np.dot(0.5*np.array([ [772.81013182, 0, 320],
[0, 779.95788961, 240 ],
[0,0,2]
]), kameraB)
kameraA = np.array([[0, -1, 0, 1], [0, 0, -1, 0],
[1, 0, 0, 0]
])
kameraA = np.dot(0.5*np.array([[768.3329645, 0, 320], [0, 770.36287522, 240 ],
[0,0,2]
]), kameraA)
A = np.array([
(r1[1])*kameraA[2] - kameraA[1],

6 | SEKCIJA ROBOTIKE STS SOMBOR ˇ

kameraA[0] - (r1[0])*kameraA[2], (r2[1])*kameraB[2] - kameraB[1], kameraB[0] - (r2[0])*kameraB[2], ])
U, S, Vt = np.linalg.svd(A)
trazeni = Vt[-1]
izlaz = trazeni[:3]/trazeni[-1] return izlaz

Utvrd– ivanje upravljackih brojeva ˇ

Kako je preslikavanje ∆p → ∆R (gde je ∆R vektor pomeraja od korena šake do vrha prsta, a ∆p projekcija istog na pravac odred–en opruženim prstom) za robotsku šaku jednoznačno, upravljanje se svodi na praćenje odnosa ∥∆p∥
∥∆R0∥

za ljudsku šaku,
gde je ∥∆R0∥ dužina opruženog prsta, i evaluaciju inverza modela prsta nad tim odnosom (unutar zadatih granica kodomena).
U zavisnosti od metoda koji smo primenili za merenje značajnih koordinata razlikujemo i dva postupka merenja vektora opruženog prsta ∆R0.
(1) Ukoliko se koristi biblioteka mediapipe, pravac opruženog prsta može se aproksimirati vektorom pomeraja od korena šake do korena prsta (smatramo da opruženi prst leži u ravni dlana, na tom pravcu), a dužina opru-ženog prsta — zbirom dužina svih njegovih segmenata od korena šake do vrha prsta.

∆R0 := X

prst

∥∆Rsegment∥ · Rkoren prsta − Rkoren sake

∥Rkoren prsta − Rkoren sake∥

(10)

(2) Ako se pak koristi ,,domaći” pristup sa segmentacijom po boji, taj vektor mora se odrediti pomoću slika raširene šake, prostim oduzimanjem koordinata vrha prsta i referentne plave tačke.

∆R0 :=
(ref. slike)
Rvrh prsta − Rref | (11)

Vektor prsta ∆R u oba slučaja odred–uje se oduzimanjem vrha prsta i ref. tačke (u slučaju prvog pristupa to je koren šake, a u slučaju drugog — plava tačka).

∆R := Rvrh prsta − Rref | (12)

Vektor ∆p dat je sledećim obrascem:

∆p := ∥∆R∥ cos ∡(∆R0, ∆R)

∆R0
∥∆R0∥

=

∆R0 · ∆R
∆R0 · ∆R0
∆R0. | (13)

Traženi odnos očevidno jeste:
∥∆p∥
∥∆R0∥

=

∆R0 · ∆R
∆R0 · ∆R0
. | (14)

Kretanje prsta modelovano je izvesnim preslikavanjem f : θ → ∥∆p∥
∥∆R0∥
| , gde je
θ ∈ [0, 1] ugao otklona motora. Funkcija f je za svaki prst uzorkovana u 180

SOFTVER PROJEKTA | 7

ravnomerno raspored–enih tačaka domena izmed–u 0 i 1 i zabeležena u lookup tabelu. Kako θ ∼ N, gde je N ∈ [0, 180] ∩ Z broj zadat motoru — pri čemu N = 180 rezultuje maksimalnim savijanjem prsta, a N = 0 potpunim opružanjem — indeks željenog ∥∆p∥
∥∆R0∥

u tabeli jeste broj koji treba zadati motoru. Za to se koristi binarna pretraga, tj. funkcija bisect biblioteke bisect.
Kod za slučaj kada se koristi biblioteka mediapipe dat je ispod. Napomena: konvencija imenovanja je izmenjena; kod je malo modifikovan radi lakšeg razumevanja.

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

Sledi primer koda (za mali prst) za slučaj kada se koristi segmentacija po boji. Napomena: konvencija imenovanja je izmenjena; kod je malo modifikovan radi lakšeg razumevanja.

def upravljackiBrojMali(): global izlaziz1
global izlaziz2

8 | SEKCIJA ROBOTIKE STS SOMBOR ˇ

global izlazz1
global izlazz2
P = izlaziz1 - izlazir1
R = izlazz1 - izlazr1
Pp = (R@P)/(P@P)
izlaz = bisect.bisect(-maliModel, -Mp) return izlaz

Modeli prstiju dobijaju se fitovanjem parametrizovanih funkcija kroz merenja prstiju, na sledeći način:

def palacFja(x):
return 0.56*np.sin(2.02*x+1.62)+0.449 def kaziprstFja(x):
return 0.29*np.sin(2.89*x+1.87)+0.71 def srednjakFja(x):
return 0.33*np.sin(2.46*x+1.94)+0.67 def domaliFja(x):
return 0.38*np.sin(3.25*x+1.89)+0.64
def maliFja(x):
return -0.45*x**2 -0.13*x + 0.99
palacModel = palacFja(np.linspace(0, 1, 180)) kaziprstModel = kaziprstFja(np.linspace(0, 0.9859, 176)) srednjakModel = srednjakFja(np.linspace(0, 1, 180)) domaliModel = domaliFja(np.linspace(0, 0.8684, 156))
maliModel = maliFja(np.linspace(0, 1, 180))

Prsti se u trenutku pisanja rada modeluju funkcijama svedenim na jedan harmonik i konstantu, tj. f-jama oblika A sin(Bθ + C) + D, budući da se osmišljeni model ,,Kinderica” pokazao previše osetljivim na neidealnosti prstiju. Model malog prsta naknadno je razvijen po Tejloru do kvadratnog člana zbog uticaja nepreciznosti računa s pokretnim zarezom (dva parametra njegove sinusoide devetog su reda veličina, a ostali brojevi s kojima radimo — reda 10−1
ili 10¹
). Domeni
odred–enih f-ja suženi su zbog neočekivanog javljanja prevojnih tačaka na domenu [0, 1] (tj. dvoznačnosti inverza).

Kodovanje i slanje poruka

Upravljački brojevi koduju se u 128-bitnu poruku oblika

A1A2A3B1B2B3C1C2C3D1D2D3E1E2E3N,

tako da je Ki reprezentacija u kodu ASCII i-te cifre sleva trocifrene dekadne reprezentacije broja K, a N znak u kodu ASCII za novi red. Takvu poruku posebna nit prosled–uje sistemu ω primenom metoda write klase Serial biblioteke pyserial. Kod je prikazan ispod.

def arduinoIzlaz():
arduino = serial.Serial(port=’/dev/ttyACM0’, baudrate=115200, timeout=.2) vreme = 0
global komanda
while True:
arduino.write(bytes(komanda, ’ascii’))

SOFTVER PROJEKTA | 9

arduino.reset_output_buffer()
nit3 = threading.Thread(target = arduinoIzlaz, args=()) nit3.start()

while True:
komanda = "".join([f"{x:03}" for x in izlazi]) + "\n"

SISTEM ω

Softver sistem ω krajnje je jednostavan i jedina mu je namena primljene upravljačke brojeve konvertovati u upravljačke signale za motore. Kada se u baferu USB porta nad–e celovita poruka dužine 128 bita, Arduino Uno je prihvati, iscepa na troslovne segmente i odbaci znak za novi red, protumači segmente kao dekadne brojeve i na osnovu njih generiše odgovarajuće PWM signale na pinovima na koje su vezani motori. Kod je priložen ispod.

#include<Servo.h>

Servo servo[5];
int angle[5] = { 0 };
int motori[5] = {3, 5, 6, 9, 10}; int c = 0;
String ulaz;
String nizUlaza[5] = { "" }; void setup() {
Serial.begin(115200);
Serial.setTimeout(10);
for (int i = 0; i < 5; i++) {
servo[i].attach(motori[i]); servo[i].write(angle[i]);
}
}
void loop() {
while (Serial.available()>=16)
{
ulaz = Serial.readStringUntil(’\n’); for (int i = 0; i < 5; i++)
{
nizUlaza[i] = "";
for (int j = 0; j < 3; j++) nizUlaza[i] += ulaz[3 * i + j]; }
for (int i = 0; i < 5; i++) angle[i] = nizUlaza[i].toInt(); }
for (int i = 0; i < 5; i++) servo[i].write(angle[i]);
}
