veljkoidjuski/povezivanjeRobotskeiLjudskeSake/kinderica/kinderica.pdf

MODEL ,,KINDERICA”

Sekcija robotike STS Sombor ˇ

Abstract. Ovaj model nazvan je ,,kinderica” jer oblikom podse´ca na ˇcokoladice kinder. On opisuje kretanje prsta naˇse robotske ˇsake pri povlaˇcenju tetive. Potreban je da bi se iz koordinata vrha prsta dobijenih trijangulacijom odluˇcilo koliko je potrebno zarotirati odgovaraju´ci servo motor. Implementiran je u obliku lookup tabele u programskoj memoriji.

Matematicka formulacija ˇ

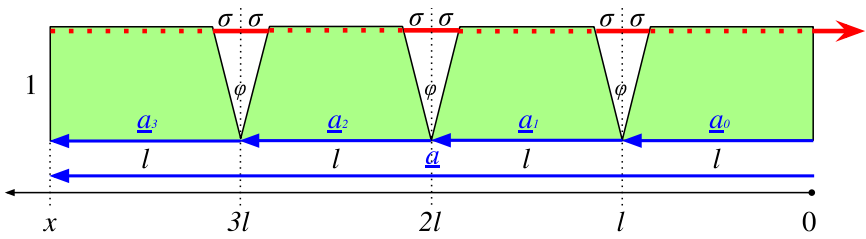
[picture p24: figure]

Slika 1. skica modela

Modeluje se kretanje prsta u zavisnosti od povlaˇcenja tetiva. Zasad prst ima jedan stepen slobode, pa je dovoljno modelovati f : ∆l 7→ x, gde je ∆l promena duˇzine tetive, a x projekcija vrha prsta na osu paralelnu opruˇzenom prstu. (jednoznaˇcno je g : x 7→ a, gde je a =

(
x
y

)
, a y osa normalna na opruˇzen prst).

a =

∑

3

i=0

ai

ai = leji(ϕ0−ϕ)

ϕ = ϕ(∆l)

(ϕ0 — maks. vrednost ϕ, ϕ0 > 0, 0 ≤ ϕ ≤ ϕ0)

=⇒ x = <

((l(e
j0 + e

j(ϕ0−ϕ) + e

j2(ϕ0−ϕ) + e

j3(ϕ0−ϕ)

))

= l(1 + cos(ϕ0 − ϕ) + cos 2(ϕ0 − ϕ) + cos 3(ϕ0 − ϕ))

= 2l

(
2 cos³

(ϕ0 − ϕ) + cos²
(ϕ0 − ϕ) − cos(ϕ0 − ϕ)

)

Typeset by AMS-TEX
1

2 | SEKCIJA ROBOTIKE STS SOMBOR ˇ
{
ϕ = 2 arctg σ
∆l = 6σ0 − 6σ

(σ0 — maks. vrednost σ, σ0 > 0, 0 ≤ σ ≤ σ0, 0 ≤ ∆l ≤ 6σ0) ⇐⇒ ϕ = 2 arctg (
σ0 −

∆l
6

)

=⇒ x = 2l

(
2 cos³

(

ϕ0 − 2 arctg (
σ0 −

∆l
6

))

+ cos²

(

ϕ0 − 2 arctg (
σ0 −

∆l
6

))

− cos (

ϕ0 − 2 arctg (
σ0 −

∆l
6

)))

(∗)

Model ,,kinderica”. Vrh prsta kre´ce se po zakonu (∗).

Implementacija

Funkciju x = x(∆l) treba fitovati kroz merenja prsta. Oblik funkcije za potrebe fitovanja glasi:

=⇒ x = α1

(
2 cos³
2

(

arctg α2 − arctg (
α2 −

∆l
6

))

+ cos²
2

(

arctg α2 − arctg (
α2 −

∆l
6

))

− cos 2 (

arctg α2 − arctg (
α2 −

∆l
6

)))

+α3

gde su α1, α2 i α3 slobodni parametri fita. Parametar α3 uveden je radi slobode definicije koordinatnog poˇcetka.
Primetimo da je, u stvari, za upravljanje prstom potreban inverz ove funkcije. Med–utim, nema potrebe saznavati ga analitiˇcki. Skup mogu´cih uglova rotacije motora je diskretan, pa se funkcija moˇze evaluirati za svaki ugao pojedinaˇcno.
