veljkoidjuski/povezivanjeRobotskeiLjudskeSake/elaborat/assets/kod1.png

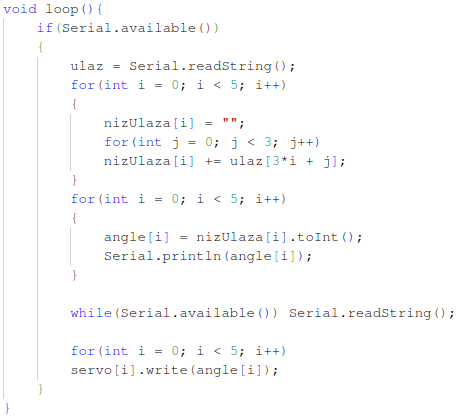
elaborat/assets/kod1.png
