veljkoidjuski/povezivanjeRobotskeiLjudskeSake/elaborat/assets/kod.png

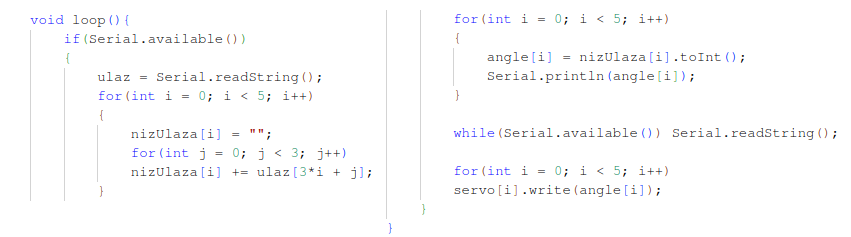
elaborat/assets/kod.png
