veljkoidjuski/povezivanjeRobotskeiLjudskeSake/elaborat/assets/rez1.jpg

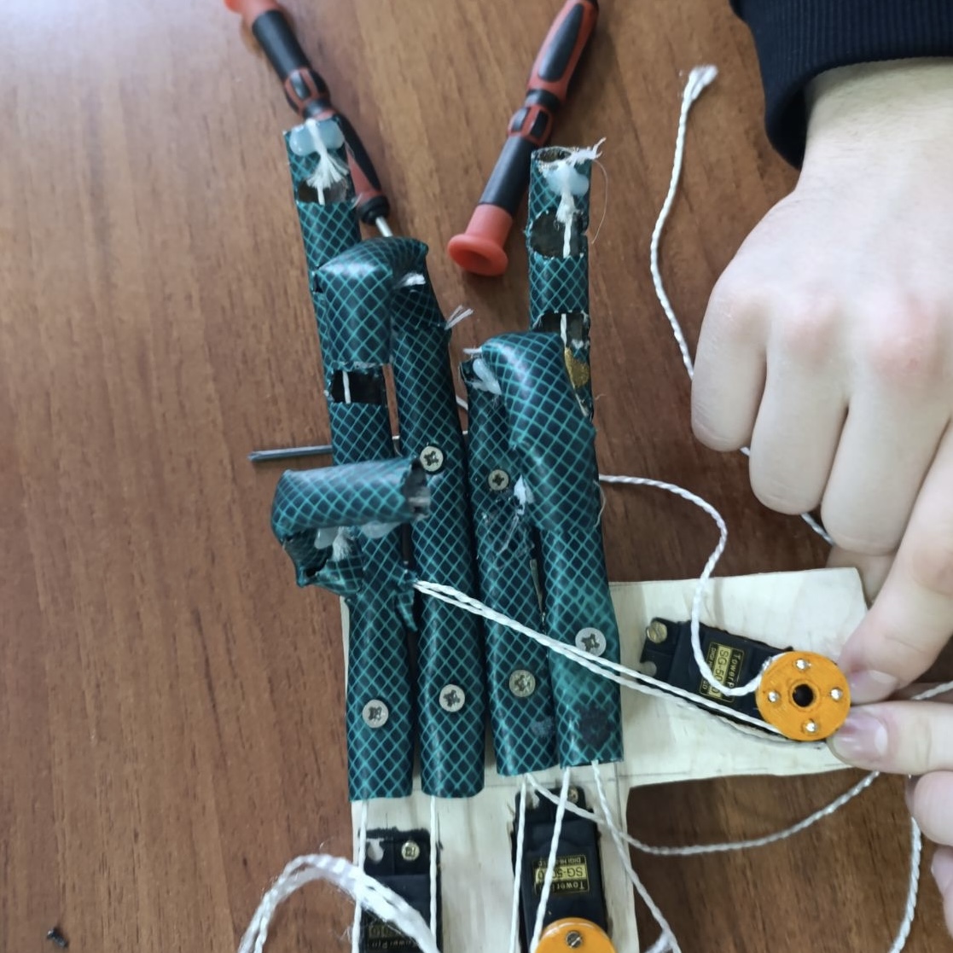
elaborat/assets/rez1.jpg
