veljkoidjuski/povezivanjeRobotskeiLjudskeSake/elaborat/assets/rezZaRad.png

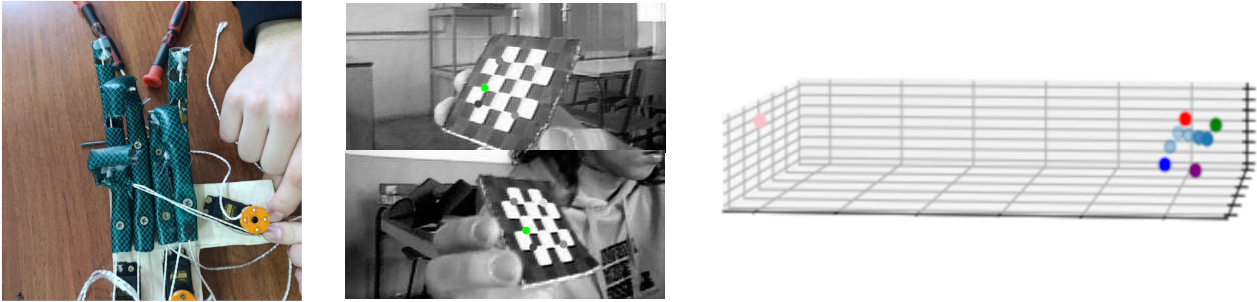
elaborat/assets/rezZaRad.png
