veljkoidjuski/povezivanjeRobotskeiLjudskeSake/elaborat/assets/slika2.jpeg

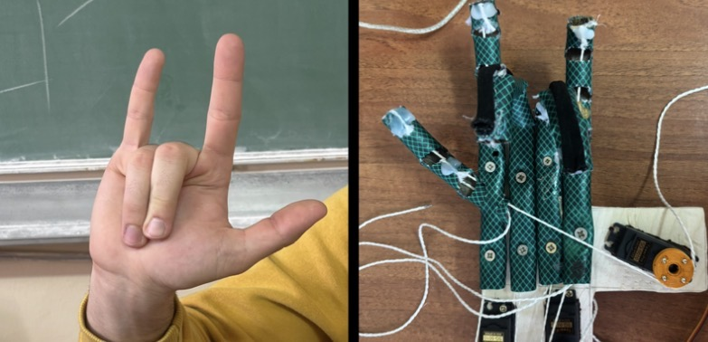
elaborat/assets/slika2.jpeg
