veljkoidjuski/povezivanjeRobotskeiLjudskeSake/elaborat/assets/slika.png

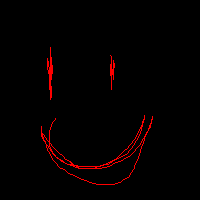
elaborat/assets/slika.png
