veljkoidjuski/povezivanjeRobotskeiLjudskeSake/kinderica/assets/model2.png

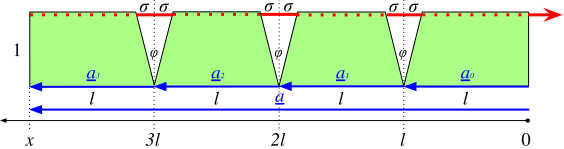
kinderica/assets/model2.png
