veljkoidjuski/povezivanjeRobotskeiLjudskeSake/prezentacijaSpanci/assets/2.png

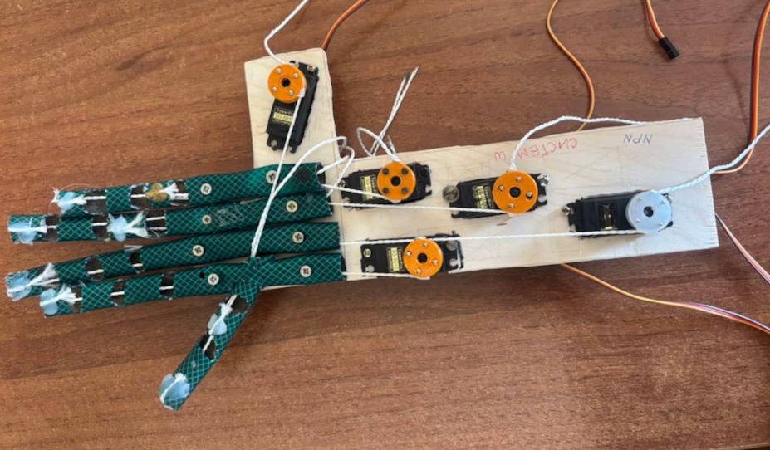
prezentacijaSpanci/assets/2.png
