veljkoidjuski/povezivanjeRobotskeiLjudskeSake/prezentacijaSpanci/assets/belo.webp

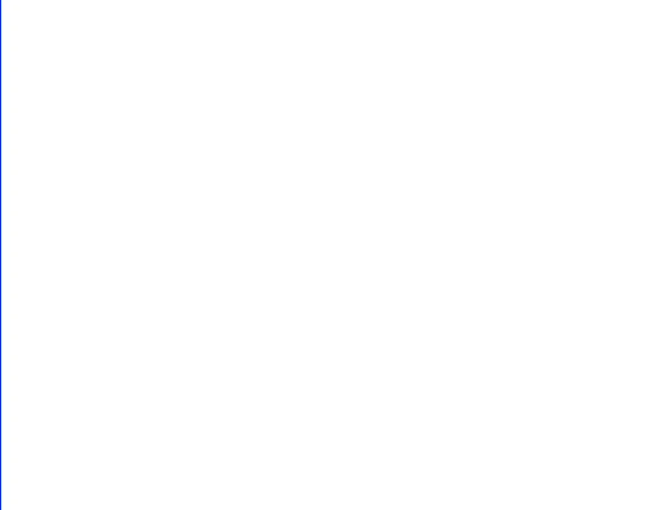
prezentacijaSpanci/assets/belo.webp
