veljkoidjuski/povezivanjeRobotskeiLjudskeSake/slikaRukovanje.jpeg

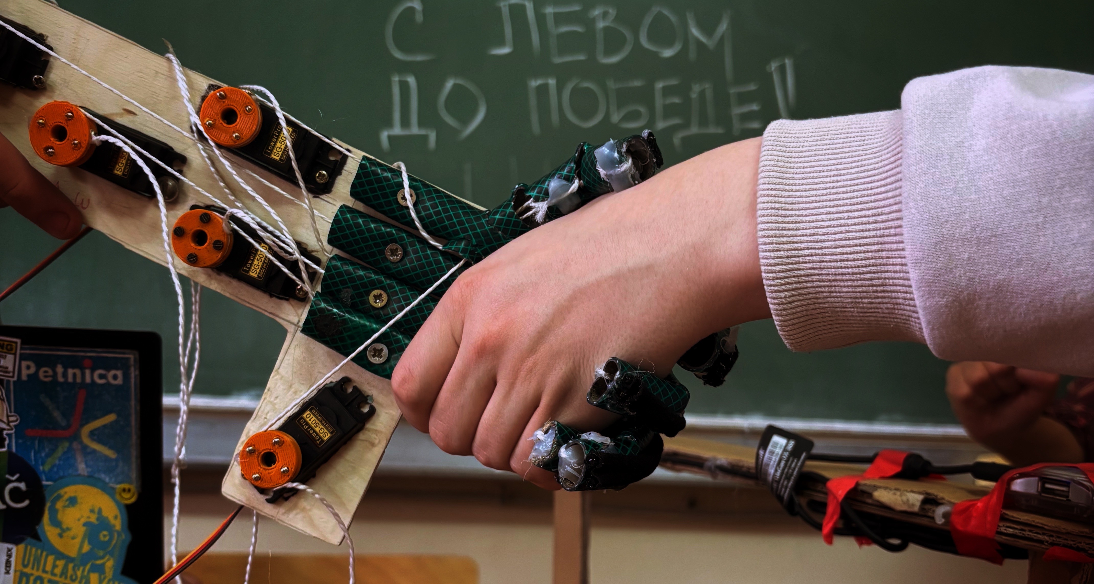
slikaRukovanje.jpeg
