veljkoidjuski/povezivanjeRobotskeiLjudskeSake/dizajnovi/plakat.pdf

С

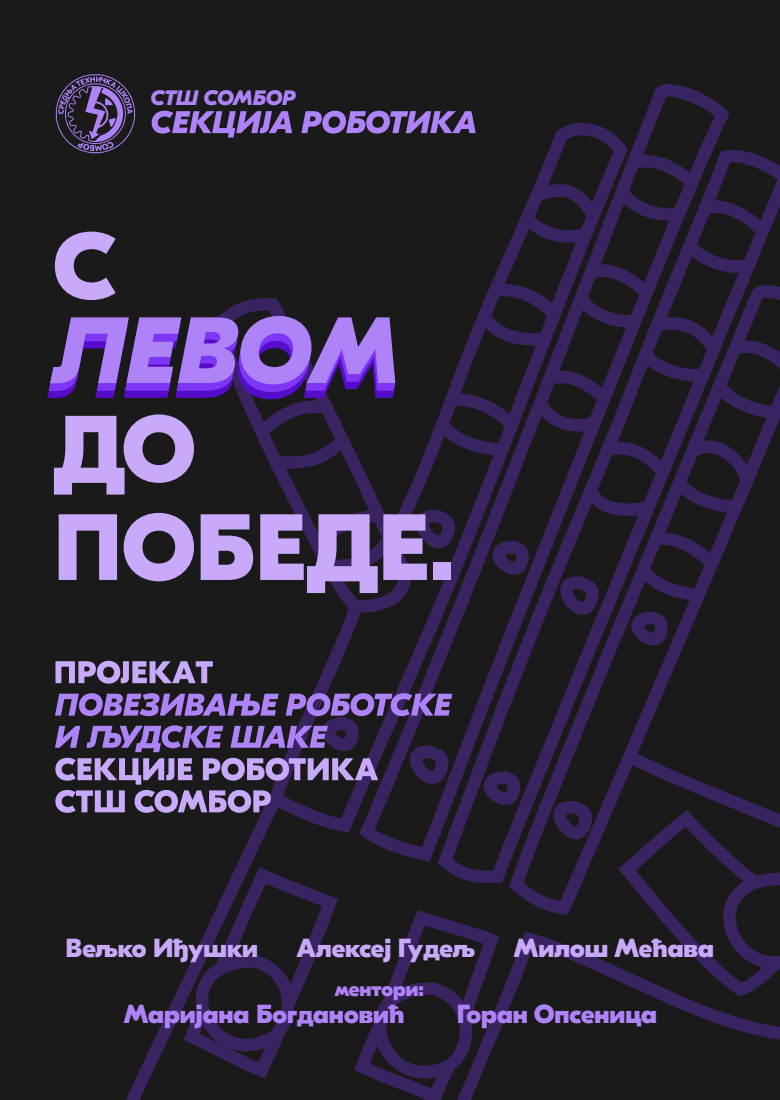
[picture p35: page 1]
СТШ СОМБОР; Вељко Иђушки; Алексеј Гудељ; Милош Мећава; ДО ПОБЕДЕ.; ментори:; Маријана Богдановић; Горан Опсеница
